danieldfgro2000/mower_bot/docs/engineering/technical/README.md

# Technical engineering index

This category owns the detailed engineering baseline, requirements, supplier
evidence, interfaces and unqualified studies. A listed part or calculated
clearance is not a release or safety qualification.

| Technical scope | Authoritative source |
| --- | --- |
| Estimate, alternatives, sourcing evidence and decisions | [Chassis BOM](bom/chassis-bom.md) · [Sources](bom/sources.md) · [Feedback](bom/feedback.md) |
| Component requirements, fit and supplier evidence | [Numbered module directory](modules/README.md) |
| Detailed estimates and allowances | [Cost breakdown](cost-breakdown.md) · [Cost ledger](bom/chassis-bom.csv) |
| Procurement and build release holds | [Chassis build requirements](chassis-build-requirements.md) |
| Width, packaging, slope and stability screen | [Width and slope feasibility](width-and-slope-sizing.md) |
| CAD geometry, modeled assumptions and clashes | [CAD study guide](cad/README.md) · [Editable SCAD model](cad/module-01-track-pod-fit.scad) |

Use the [generated presentation](../presentation/README.md) for a concise
summary with the 3D viewer. See the [agent guide](../agents/README.md) for
maintenance procedures.

[↑ Back to engineering documentation](../README.md)
