danieldfgro2000/mower_bot/docs/engineering/modules/02-drive-train/README.md

# Module 02 — Drive train

**Summary:** Start with the motor, inspect its price and data, then follow
the mounting path to the track. HPM5000B, EZ-A48500 and FDB 13 C are the
costed candidates; custom reduction and brake installation remain unpriced.
Neither these nor non-additive alternatives are approved or installed selections.

| Part / configuration | Price, data and next connection |
| --- | --- |
| [HPM5000B main candidate](propulsion.md#hpm5000b-main-motor-candidate) | [Price](propulsion.md#hpm5000b-purchase-scope-and-price) · [Specifications](propulsion.md#hpm5000b-ratings-and-sourcing-limits) · [Mounting to the track](propulsion.md#motor-to-track-mounting) |
| [EZ-A48500 controller](propulsion.md#ez-a48500-controller-candidate) | [Price and comparison](propulsion.md#ez-a48500-controller-candidate) · [Electrical compatibility](propulsion.md#compatibility-and-duty-limitations) |
| [Former BLDC 48 V planetary package](propulsion.md#48-v--approximately-2-kw-per-drive) | [Non-additive motor/controller/brake reference](propulsion.md#48-v--approximately-2-kw-per-drive) · [Output shaft and bearings](propulsion.md#ps16-output-shafts-and-bearings) |
| [Reduction, drive hub and supports](propulsion.md#motor-to-track-mounting) | [In-drum study](propulsion.md#hpm5000b-planetary-in-drum-study) · [Track engagement](../01-structure-and-running-gear/running-gear.md#drive-drum-study) · [Frame mounting plates](../01-structure-and-running-gear/frame.md#motor-and-reducer-mounting-plates) |
| [Precima FDB 13 C holding brake](propulsion.md#precima-fdb-13-c-holding-brake-candidate) | [Supplier price and data](propulsion.md#precima-fdb-13-c-holding-brake-candidate) · [HPM fitment](propulsion.md#fdb-13-c-to-hpm5000b-fitment) · [Independent stop](../06-safety-controls-and-sensors/safety-controls.md#ps28-independent-stopping-and-normal-control) |

**Related documents:** [All drive parts](propulsion.md#parts-at-a-glance) ·
[Module cost detail](../../cost-breakdown.md#02--drive-train) ·
[All modules](../README.md)

[↑ Back to module overview](README.md#module-02--drive-train)
