danieldfgro2000/mower_bot/docs/engineering/modules/05-power-cables-and-electronics/README.md

# Module 05 — Power cables and electronics

**Summary:** Power and signal wiring, protective switching, supplies, and
electronics enclosures. Component ratings and installation remain unqualified;
independent stop requirements belong to [Module 06](../06-safety-controls-and-sensors/README.md).

| Start with a part | Then inspect its connection |
| --- | --- |
| [Power cable, lugs and connectors](cables-connectors.md#ps23-high-current-harness) | [Fuse coordination](power-distribution.md#ps21-main-fuses-disconnects-and-contactors) · [Crimp tools/dies](../07-workshop-and-support/workshop.md#ps36-instruments-and-workshop-tools) |
| [Contactors and disconnects](power-distribution.md#ps21-main-fuses-disconnects-and-contactors) | [Battery/BMS](../04-battery-and-charging/batteries.md#ps18-battery-packs-and-bms) · [Independent stop](../06-safety-controls-and-sensors/safety-controls.md#ps28-independent-stopping-and-normal-control) |
| [Control supplies](power-distribution.md#ps24-control-supplies-and-branch-protection) | [Control boards](../06-safety-controls-and-sensors/safety-controls.md#ps29-normal-control-and-diagnostics) · [Brake-coil loads](../02-drive-train/propulsion.md#ps15-mechanical-brakes) |
| [Printed boxes and glands](power-distribution.md#ps25-printed-enclosures-and-cable-glands) | [Controller heat path and mounting](power-distribution.md#ps27-thermal-paths-and-enclosure-hardware) · [Cable entry](cables-connectors.md#ps23-high-current-harness) |
| [Signal cable/connectors](cables-connectors.md#ps26-signal-harness-and-communications) | [Sensors/logger](../06-safety-controls-and-sensors/safety-controls.md#ps31-installed-instrumentation-and-logging) · [Moving width harness](../03-width-adjustment/width-adjustment.md#ps13-width-harness-and-screw-guard) |

**Related documents:** [Cable/connector parts and costs](cables-connectors.md#parts-at-a-glance) ·
[Power-distribution parts and costs](power-distribution.md#parts-at-a-glance) ·
[Module cost detail](../../cost-breakdown.md#05--power-cables-and-electronics) ·
[All modules](../README.md)

[↑ Back to module overview](README.md#module-05--power-cables-and-electronics)
