danieldfgro2000/mower_bot/docs/engineering/modules/01-structure-and-running-gear/README.md

# Module 01 — Structure and running gear

**Summary:** The two tracked pods and their connecting frame. Dimensions,
loads, materials, and undercarriage compatibility remain unqualified; neither
scope releases procurement or fabrication.

| Start with a part | Then inspect its connection |
| --- | --- |
| [Track, rollers and tensioner: choices, costs and data](running-gear.md#parts-at-a-glance) | [Drive drum](running-gear.md#drive-drum-study) → [motor-to-track mounting](../02-drive-train/propulsion.md#motor-to-track-mounting) |
| [Motor mounting plates](frame.md#motor-and-reducer-mounting-plates) | [Motor data](../02-drive-train/propulsion.md#parts-at-a-glance) · [Output bearings](../02-drive-train/propulsion.md#ps16-output-shafts-and-bearings) |
| [Frame, pivots, locks and guards](frame.md#parts-at-a-glance) | [Width screw and supports](../03-width-adjustment/width-adjustment.md#ps10-screw-drive-and-supports) · [Width holding](../03-width-adjustment/width-adjustment.md#width-holding-and-stopping) |
| [Installed lifting/recovery points](frame.md#ps32-installed-lifting-and-recovery-points) | [Transport straps and service supports](../07-workshop-and-support/workshop.md#ps33-transport-straps-and-service-supports) |
| [Pod-fit CAD](../../cad/module-01-track-pod-fit.scad) | [Battery fit and removal](../04-battery-and-charging/batteries.md#battery-to-pod-fit) · [Tensioner clearance](../../width-and-slope-sizing.md#tensioner-and-idler-interfaces) |

**Related documents:** [Running-gear scope](running-gear.md) ·
[Frame, scissor and spine scope](frame.md) ·
[Module cost detail](../../cost-breakdown.md#01--structure-and-running-gear) ·
[All modules](../README.md)

[↑ Back to module overview](README.md#module-01--structure-and-running-gear)
