danieldfgro2000/mower_bot/docs/engineering/modules/03-width-adjustment/README.md

# Module 03 — Width adjustment

**Summary:** The proposed powered width-adjustment mechanism, from the reused
motor to the screw, feedback, and guarding. Holding and motion limits remain
unresolved; this is not a released mechanism.

| Start with a part | Then inspect its connection |
| --- | --- |
| [Reused motor: data and cost basis](width-adjustment.md#donor-motor-and-allowance) | [Coupling, screw and supports](width-adjustment.md#ps10-screw-drive-and-supports) → [scissor pivots](../01-structure-and-running-gear/frame.md#ps05-scissor-pivots) |
| [Converter and reversible driver](width-adjustment.md#ps11-width-drive-power-and-protection) | [Motor current/duty requirements](width-adjustment.md#ps09-reused-wiper-motor) · [Traction-pack limits](../04-battery-and-charging/batteries.md#ps18-battery-packs-and-bms) |
| [Encoder, reference and limits](width-adjustment.md#ps12-width-feedback-and-limits) | [Turns-to-width relationship](width-adjustment.md#position-feedback-and-rolling-speed) · [Positive lock and hard stops](../01-structure-and-running-gear/frame.md#ps06-width-holding-and-hard-stops) |
| [Harness and screw guard](width-adjustment.md#ps13-width-harness-and-screw-guard) | [Signal routing](../05-power-cables-and-electronics/cables-connectors.md#ps26-signal-harness-and-communications) · [Main scissor guards](../01-structure-and-running-gear/frame.md#ps07-guards-and-edge-protection) |

**Related documents:** [All width-drive parts and costs](width-adjustment.md#parts-at-a-glance) ·
[Holding and stopping conflict](width-adjustment.md#width-holding-and-stopping) ·
[Module cost detail](../../cost-breakdown.md#03--width-adjustment) ·
[All modules](../README.md)

[↑ Back to module overview](README.md#module-03--width-adjustment)
