danieldfgro2000/mower_bot/docs/engineering/modules/06-safety-controls-and-sensors/README.md

# Module 06 — Safety controls and sensors

**Summary:** Independent stopping, normal controls, interlocks, sensors, and
logging. Mobile-app control and a general hardware E-stop are owner intent,
not verified stopping behavior; all requirements remain on hold.

| Start with a part | Then inspect its connection |
| --- | --- |
| [E-stop, relay and reset](safety-controls.md#ps28-independent-stopping-and-normal-control) | [Contactors](../05-power-cables-and-electronics/power-distribution.md#ps21-main-fuses-disconnects-and-contactors) · [Motor braking and mechanical hold](../02-drive-train/propulsion.md#owner-braking-direction-2026-10-27) |
| [Control boards and diagnostics](safety-controls.md#ps29-normal-control-and-diagnostics) | [Power supplies](../05-power-cables-and-electronics/power-distribution.md#ps24-control-supplies-and-branch-protection) · [Signal harness](../05-power-cables-and-electronics/cables-connectors.md#ps26-signal-harness-and-communications) |
| [Tilt and guard interlocks](safety-controls.md#ps30-tilt-sensing-and-interlocks) | [Guard mounting](../01-structure-and-running-gear/frame.md#ps07-guards-and-edge-protection) · [Configuration-dependent stability](../../width-and-slope-sizing.md#lateral-static-tipping-screen) |
| [Drive sensors and logger](safety-controls.md#ps31-installed-instrumentation-and-logging) | [Clamp meter and measurement tools](../07-workshop-and-support/workshop.md#ps36-instruments-and-workshop-tools) · [Planned bench observations](../07-workshop-and-support/workshop.md#test-method-and-evidence) |

**Related documents:** [All controls/sensors and costs](safety-controls.md#parts-at-a-glance) ·
[Module cost detail](../../cost-breakdown.md#06--safety-controls-and-sensors) ·
[All modules](../README.md)

**Retired cost number:** 06.02 was the industrial operator remote purchase
allowance. It is intentionally left unused after the
[mobile-app control decision](../../bom/feedback.md#f10-workshop-equipment-test-method-and-mobile-app-control);
remaining submodule numbers are retained for stable cross-references.
The app is not the independent emergency stop.

[↑ Back to module overview](README.md#module-06--safety-controls-and-sensors)
