danieldfgro2000/mower_bot/docs/engineering/modules/07-workshop-and-support/README.md

# Module 07 — Workshop and support

**Summary:** Bench fixture, workshop tools, handling equipment, consumables,
and PPE for planned staged checks. Torque remains calculated, not measured;
reused inventory and all test arrangements still need qualification.

| Start with an item | Then inspect what it serves |
| --- | --- |
| [Workshop tools: prices, reuse and limits](workshop.md#ps36-instruments-and-workshop-tools) | [Power connectors/crimping](../05-power-cables-and-electronics/cables-connectors.md#ps23-high-current-harness) · [Frame joints/torque wrench](../01-structure-and-running-gear/frame.md#ps08-fasteners-coatings-and-labels) |
| [Guarded bench fixture](workshop.md#ps34-bench-fixture-and-controls) | [Motor/drive interfaces](../02-drive-train/propulsion.md#motor-to-track-mounting) · [Independent stop](../06-safety-controls-and-sensors/safety-controls.md#ps28-independent-stopping-and-normal-control) |
| [Transport straps and supports](workshop.md#ps33-transport-straps-and-service-supports) | [Installed frame points](../01-structure-and-running-gear/frame.md#ps32-installed-lifting-and-recovery-points) |
| [Consumables and initial spares](workshop.md#ps37-fabrication-consumables) | [Frame weldments](../01-structure-and-running-gear/frame.md#ps04-frame-stock-and-weldments) · [Spare-part matching](workshop.md#ps38-initial-spare-parts) |
| [PPE, fire provision and cleaning](workshop.md#ps39-ppe-charging-area-and-cleaning) | [Charging conditions](../04-battery-and-charging/batteries.md#ps20-charging-and-charge-interlocks) · [Controlled bench area](workshop.md#ps34-bench-fixture-and-controls) |

**Related documents:** [All workshop items and costs](workshop.md#parts-at-a-glance) ·
[Test method and its limits](workshop.md#test-method-and-evidence) ·
[Module cost detail](../../cost-breakdown.md#07--workshop-and-support) ·
[All modules](../README.md)

**Retired cost number:** 07.03 was the dynamometer/torque-measurement package.
It is intentionally left unused after the
[test-method decision](../../bom/feedback.md#f10-workshop-equipment-test-method-and-mobile-app-control);
later submodule numbers are retained for stable cross-references.

[↑ Back to module overview](README.md#module-07--workshop-and-support)
