danieldfgro2000/mower_bot/docs/engineering/technical/modules/01-structure-and-running-gear/running-gear.md

# Tracks and running gear

**Status:** DRAFT / HOLD; engineering estimate and unqualified requirements.
No procurement, fabrication, energizing or operation is authorized.

**Summary:** Follow the track around the drive drum, support rollers, idler,
and tensioner. Nominal track size and layout choices are study inputs;
matched profiles, bearings, clearances, and load ratings remain unqualified.

## Parts at a glance

| Part to inspect | Current choice / status | Cost and specifications | Fit / next component |
| --- | --- | --- | --- |
| [Rubber track](running-gear.md#ps01-rubber-tracks) | PowerTrack `180×72×37` initial sourcing preference; `200×72×40` owner-accepted candidate for the longer-loop study; `200×72×36` remains the unchanged baseline study reference | [Found prices](running-gear.md#prices-found-tracks-rollers-and-idlers) · [Baseline allowance](running-gear.md#0101-rubber-tracks) · [Track requirements](running-gear.md#ps01-rubber-tracks) | [Drive drum engagement](running-gear.md#drive-drum-study) |
| [Drive drum / sprocket](running-gear.md#drive-drum-study) | 350 mm physical OD is a flexible study placeholder; tooth/profile match open | [Baseline sprocket/hub allowance](running-gear.md#0102-sprockets-idlers-rollers-and-tensioners) · [Drum study](running-gear.md#drive-drum-study) | [Motor-to-track mounting](../02-drive-train/propulsion.md#motor-to-track-mounting) |
| [Lower support rollers](running-gear.md#lower-support-rollers) | Bearing-wheel route; printed 120 mm PC/TPU wheels owner-selected, Interwheel 160 mm fallback; four assemblies per track in the study; fit and capacity unqualified | [Found prices](running-gear.md#prices-found-tracks-rollers-and-idlers) · [Roller allowance](running-gear.md#0102-sprockets-idlers-rollers-and-tensioners) · [Roller definition](running-gear.md#lower-support-rollers) | [Axles and bearings](running-gear.md#ps03-axles-bearings-and-track-guides) |
| [Fixed upper rollers and spring idler](running-gear.md#spring-tensioner-concept) | Owner-selected sliding front-idler spring + fixed upper roller; custom supports modeled, loads unqualified | [Roller/tensioner allowances](running-gear.md#0102-sprockets-idlers-rollers-and-tensioners) · [Travel/load requirements](running-gear.md#ps02-sprockets-rollers-and-tensioners) | [Battery and carrier clearance](running-gear.md#tensioner-and-idler-interfaces) |
| Front idler | Bearing-wheel route preferred; priced excavator alternative also recorded; neither fit qualified | [Found prices](running-gear.md#prices-found-tracks-rollers-and-idlers) · [Idler allowance](running-gear.md#0102-sprockets-idlers-rollers-and-tensioners) · [Supplier limitations](running-gear.md#s37-bearing-wheel-roller-and-idler-candidates) | [Track compatibility](running-gear.md#ps01-rubber-tracks) |
| [Axles, bearings and guides](running-gear.md#ps03-axles-bearings-and-track-guides) | Sizes, fits and retained assembly open | [Support costs](running-gear.md#0103-track-axles-bearings-guides-and-scrapers) · [Required data](running-gear.md#ps03-axles-bearings-and-track-guides) | [Pod frame](frame.md#ps04-frame-stock-and-weldments) |

**3D study:** Click a thumbnail in the [local CAD reader](../../cad/README.md)
to select the part; clicking its mesh opens the corresponding section here.
The revised candidate study shows the accepted 200 x 72 x 40 track, unchanged
paired 120 mm lower wheels, a raised 120 mm upper pair and 200 mm bought idler
pair. Battery/tray clashes are cleared with provisional margins. Guide
dimensions are schematic. U supports, axles, a fixed upper mast and sliding
spring-idler hardware are now modeled custom proposals; their loads, joints
and durability remain unqualified.

| Track | Drive drum | Idler | Lower rollers |
| --- | --- | --- | --- |
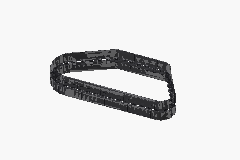
[picture p14: docs/engineering/presentation/viewer/previews/track.png]
3D track
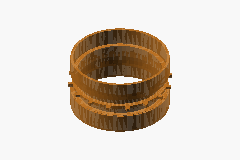
[picture p15: docs/engineering/presentation/viewer/previews/drive-drum.png]
3D drum
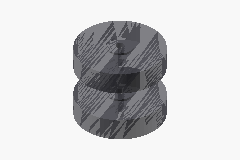
[picture p16: docs/engineering/presentation/viewer/previews/idler.png]
3D idler
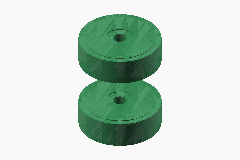
[picture p17: docs/engineering/presentation/viewer/previews/lower-roller-1.png]
3D lower roller
|  |  |  |  |

Other individual rollers: [3D roller 2](../../../presentation/viewer/index.html?component=lower-roller-2) ·
[3D roller 3](../../../presentation/viewer/index.html?component=lower-roller-3) ·
[3D roller 4](../../../presentation/viewer/index.html?component=lower-roller-4).

3D upper return roller

| Lower U supports | Fixed upper support | Sliding idler carriage | Idler spring / reaction |
| --- | --- | --- | --- |
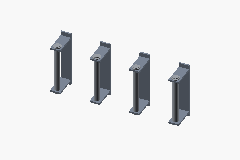
[picture p18: docs/engineering/presentation/viewer/previews/lower-roller-supports.png]
3D lower U supports
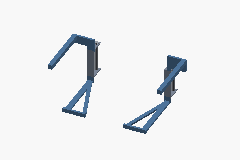
[picture p19: docs/engineering/presentation/viewer/previews/upper-roller-support.png]
3D upper support
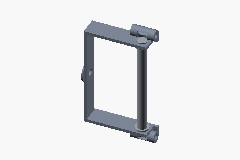
[picture p20: docs/engineering/presentation/viewer/previews/idler-carriage.png]
3D sliding idler carriage
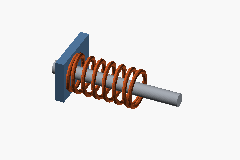
[picture p21: docs/engineering/presentation/viewer/previews/idler-spring.png]
3D idler spring
|  |  |  |  |

**Further detail:** [Prices found](running-gear.md#prices-found-tracks-rollers-and-idlers) ·
[Track length check](running-gear.md#track-length-check) ·
[Release requirements](running-gear.md#specification-and-inspection-requirements) ·
[Roller and drum concepts](running-gear.md#ps02-sprockets-rollers-and-tensioners) ·
[Sourcing](running-gear.md#sourcing) ·
[Interfaces](running-gear.md#interfaces-with-other-scopes) ·
[Itemized costs](running-gear.md#detailed-module-costs) ·
[Procurement and holds](running-gear.md#procurement-and-release-holds) ·
[Decision records](running-gear.md#decision-records) ·
[Supplier evidence](running-gear.md#supplier-evidence)

**Related documents:** [Pod-fit CAD](../../cad/module-01-track-pod-fit.scad) ·
[Chassis BOM](../../bom/chassis-bom.md) ·
[All modules](../README.md#module-directory)

## Prices found: tracks, rollers and idlers

**Public prices recorded 2026-10-29, not BOM allowances.** Product names below
open the supplier listings. These are unqualified sourcing candidates;
dimensions, including drum diameter, remain flexible.

| Part / supplier | Price per purchased piece | Pair / assembly price | Price basis |
| --- | ---: | ---: | --- |
| **Track: PowerTrack 180 x 72 x 37**, sourcing preference ([buy / price](https://www.powertrack.it/en/powertrack-rubber-tracks/2001-rubber-tracks-for-miniexcavators-180x72x37-0793596791918.html)) | **EUR91.35** | **EUR169.92 for two tracks**, after 7% pair discount | Includes 22% Italian VAT; pair is EUR139.28 net |
| **Track candidate: PowerTrack 200 x 72 x 40**, owner-accepted for evaluation ([buy / price](https://www.powertrack.it/en/powertrack-rubber-tracks/2055-Rubber-tracks-for-miniexcavators-200x72x40-0793596792076.html)) | **EUR119.27** | **EUR221.84 for two tracks**, at EUR110.92 each | Includes 22% Italian VAT; listed in stock; Romanian delivery/VAT unconfirmed |
| Track alternative: PowerTrack 200 x 72 x 36 ([buy / price](https://www.powertrack.it/en/powertrack-rubber-tracks/2023-Rubber-tracks-for-miniexcavators-200x72x36-0793596792038.html)) | **EUR138.52** | **EUR257.64 for two tracks**, after 7% pair discount | Includes 22% Italian VAT; pair is EUR211.18 net |
| **Roller wheel: Interwheel 161.535**, 160 mm PU, 20 mm bore ([buy / price](https://www.interwheel.eu/en/stainless-steel-pu-wheel-160-mm-450-kg.html)) | **EUR22.88** | **EUR45.76 per two-wheel roller** | Excludes VAT, shaft, spacers and bracket |
| **Idler wheel: Interwheel 161.540**, 200 mm PU, 20 mm bore ([buy / price](https://www.interwheel.eu/en/stainless-steel-pu-wheel-200-mm-500-kg.html)) | **EUR26.55** | **EUR53.10 per two-wheel idler** | Excludes VAT, shaft, spacers and bracket |
| Light roller price reference: Interwheel 161.420, 125 mm PU, 10 mm bore ([buy / price](https://www.interwheel.eu/en/stainless-steel-pu-wheel-125-mm-200-kg.html)) | **EUR7.73** | **EUR15.46 per two-wheel roller** | Excludes VAT and mounting parts; shared-shaft suitability unresolved |
| Excavator roller alternative: genuine Kubota, Officine Fabbri ([buy / price](https://www.officinefabbri.it/it/k0083-cingoli-rulli/2700-rullo-inferiore-superiore-originale-kubota-classic-line-k008-3-e-u10-3.html)) | **EUR71.29 net** | One complete roller, not a wheel pair | EUR86.98 including 22% Italian VAT |
| Excavator idler alternative: Astrak ID072/293/00, BaggerteileShop24 ([buy / price](https://baggerteileshop24.de/products/kubota-k008-3-leitrad-mit-halter)) | **EUR186.00 net** | One idler with bracket, not a wheel pair | VAT excluded on the recorded retailer basis |

**Bearing-wheel route, required quantities:** 20 x 160 mm wheels for eight
lower and two upper roller assemblies = **EUR457.60 net**; four x 200 mm
wheels for two idlers = **EUR106.20 net**. With the discounted 180 mm track
pair, the component subtotal is **EUR703.08 net**. Listed Interwheel shipping
to Romania is approximately **EUR71.02**, giving **EUR774.10 before VAT,
track delivery and fabrication/mounting parts**. This is not a delivered
complete-undercarriage price.

**Roller sourcing selection (owner-selected, 2026-10-29): 3D-printed
120 mm roller wheels** with a PC core, TPU 95A tread and two bought 6004-2RS
bearings each. Recommendation, not an owner decision: idlers stay bought
until their tension load is known. The current CAD needs 24 wheels (16 x 120 mm
lower, 8 x 70 mm upper), about **EUR190.79 net** (3DJake sale filament, free
delivery) or EUR222.79 at regular prices, excluding print time and an
enclosure. The Interwheel 160 mm wheels above (EUR457.60 for 20) are the
fallback if print time becomes a bottleneck. Printed wheels have no load
rating; confirm the R2 guide-horn height and roller groove before printing the full set. See
[S38](running-gear.md#s38-3d-printed-roller-wheels-owner-proposed).

**Evidence and limitations:** [Track prices and discount](running-gear.md#powertrack-track-comparison) ·
[Bearing-wheel prices, shipping and fit](running-gear.md#s37-bearing-wheel-roller-and-idler-candidates) ·
[All priced excavator alternatives](running-gear.md#s36-priced-kubota-k008-3-undercarriage-candidates).
Romanian checkout VAT and PowerTrack delivery remain unconfirmed.
The [generated costs below](running-gear.md#detailed-module-costs) are the
unchanged baseline allowances, not these found prices.

## Track length check

**Detail:** [Pitch-loop geometry](running-gear.md#pitch-loop-geometry) ·
[Pod-fit CAD assumptions](running-gear.md#pod-fit-cad-assumptions) ·
[Tensioner and idler interfaces](running-gear.md#tensioner-and-idler-interfaces) ·
[Battery clearance](../04-battery-and-charging/batteries.md#provisional-battery-clearance).

### Pitch-loop geometry

If the listing code follows the usual convention, nominal pitch-loop length is
`72 × 36 = 2,592 mm`. The [PowerTrack page](running-gear.md#s01-powertrack-rubber-tracks) does not confirm that interpretation or
publish the track's measured loop length. For an illustrative two-equal-wheel
oval path with radius `r` and wheel-centre separation `a`:

`2,592 = 2a + 2πr`; longitudinal pitch envelope `E = a + 2r`.

At **r = 100 mm**, `a ≈ 981.8 mm` and `E ≈ 1,181.8 mm`, before actual tread
thickness and structural overhangs. This is **not** the selected sprocket size
or layout. It shows why an 800 mm complete pod length must not be inferred
from the proposed 1,600 mm width or a width/length ratio. Actual roller/idler
geometry, track pitch line and wrap determine the envelope.

### Pod-fit CAD assumptions

The [editable candidate study](../../cad/module-01-track-pod-fit.scad) now uses the
owner-accepted 200 x 72 x 40 candidate, interpreting the code as width, pitch and
link count (2,880 mm assumed pitch loop). The drive drum remains a flexible
**350 mm OD placeholder**; the idler now shows two Interwheel 200 mm wheels,
each 50 mm tread / 60 mm hub with 20 mm bore. This is a candidate representation,
not selection or qualification of that idler.

PowerTrack lists roller type **R2** for this track
([S39](running-gear.md#s39-longer-powertrack-belt-candidates)): each metal
link carries two guide horns and the rollers run on the rubber outboard of
both horns, not between them. The CAD therefore uses a **70 mm tread-face
groove**. Four lower assemblies each have two 120 x 40 mm printed wheels with
an 8 mm tread and two 6004 bearing envelopes per wheel; the 150 mm
lower/upper-pair width is kept, so each printed wheel narrows from 50 to 40 mm.
The Interwheel idler's 50 mm treads sit at Z = +/-60 mm (170 mm tread and
180 mm hub envelopes); the hubs sit radially inside the horn tips. Each horn
flank keeps **6 mm** to the wheel, idler-tread and drum-band faces (5 mm
provisional). The catalogue idler treads reach Z = +/-85 mm, 11 mm past the
start of the illustrative shoulder taper, so their effective contact width is
HOLD. Wheel diameters and bearing dimensions are retained.

The illustrative R2 profile is rounded from image-scale estimates and is
**not supplier dimensions**: per 72 mm link, two trapezoidal horns at
Z = +/-19.5 mm, 19 mm high, 19/6 mm wide and 30/20 mm long at base/tip; a
20 x 30 mm metal link land between them, leaving a 42 mm-long open window per
pitch in a 20 mm central channel; a 3.5 mm inner-face shoulder taper outboard
of Z = +/-74 mm; a 15 x 10 mm ground-edge chamfer; and 36 mm-long, 6 mm-high
tread blocks spanning 12-84 mm from the centreline, alternating sides each
half pitch. The belt stays 20 mm thick, although the R2 image scales to about
31.5 mm (HOLD). Confirm horn, groove and rolling-path dimensions before using
any groove, spacer, bearing fit or printed geometry.

With the assumed 20 mm belt and mid-thickness pitch line, two fixed 70 mm upper pairs
at X = 245 and X = -195, both Y = 510 mm, give **850.308 mm horizontal
end-axis spacing**. Drive X stays -440 mm; the idler is at X = +410.308 mm.
The actual four-circle
tangents and arcs close the 40-link loop. The 504 x 268 x 233 mm battery
is at X = 35, Z = 44 mm with bottom Y = 158 mm; the fixed carrier underside is Y = 140 mm,
10 mm above the lower wheels. Nominal body clearances to the 19 mm R2 horn tips are 41.5 / 104.0 mm
normal to the front/rear return runs. Reserving 10 mm for motion and 5 mm for
deflection/tolerances leaves at least **26.5 mm** versus a provisional 20 mm
running requirement. See the [CAD dimensions and limits](../../cad/README.md#modeled-dimensions-and-limits)
for mesh checks, extraction, transverse fit and remaining holds.

This is a candidate study, not a purchase/baseline change. The recorded
200 x 72 x 40 pair costs EUR221.84 including listed Italian VAT, **EUR51.92
more than the 180 x 72 x 37 pair**, and its listed mass adds 24 kg per pair
versus that initial candidate (8 kg versus the 200 x 72 x 36 baseline reference).
The already-planned upper pair completes the existing 20-wheel quantity;
no extra wheels or changed BOM allowances are implied.

### Low-profile packaging investigation

**Owner brief, 2026-10-29:** Investigate approximately 30 mm-OD rollers on
U-shaped supports (more rollers are acceptable), a lower tray/main track frame,
longer tracks and larger idlers before moving the battery to a side bay.
Place the battery toward one transverse side, not centered, to reduce intrusion
into the width-adjustment space. These are investigation directions, not a
replacement component selection. **Historical investigation:** the revised
SCAD below retains 120 mm lower wheels, rather than adopting the small-wheel
screens.

**First screen:** Neither smaller lower rollers alone nor a longer belt alone
raises the current low front return enough. A higher return path is also needed.
Before buying a large custom idler, investigate using the already-planned upper
roller to route the return above the battery.

| Candidate | Public price each | Pair at listed quantity tier | Status / difference from 37-link pair |
| --- | ---: | ---: | --- |
| [180 x 72 x 37](running-gear.md#s34-powertrack-180-x-72-x-37-candidate), current reference | EUR91.35 | EUR169.92 | Listed in stock |
| [180 x 72 x 40](running-gear.md#s39-longer-powertrack-belt-candidates) | **EUR131.96** | **EUR245.44** | Listed in stock; **+EUR75.52**; nominal loop +216 mm, listed pair mass +4 kg |
| [200 x 72 x 40](running-gear.md#s39-longer-powertrack-belt-candidates), owner-accepted candidate | **EUR119.27** | **EUR221.84** | Listed in stock; **+EUR51.92**; nominal loop +216 mm, width +20 mm; EUR23.60 less per pair than 180 x 72 x 40 |
| [180 x 72 x 41K](running-gear.md#s39-longer-powertrack-belt-candidates) | EUR138.30 | EUR257.24 | Preorder; +EUR87.32; K guide/profile compatibility unconfirmed |
| [180 x 72 x 43Y](running-gear.md#s39-longer-powertrack-belt-candidates) | EUR175.09 | EUR325.66 | Listed in stock; +EUR155.74; Y guide/profile compatibility unconfirmed |

These are public guest-page prices, not Romanian delivered prices. Do not
assume K/Y suffixes describe interchangeable internal profiles.

**Owner clarification, 2026-10-29:** The 200 x 72 x 40 is a valid candidate;
180 mm width is not a constraint. Its assumed nominal loop is 2,880 mm.
Acceptance is for evaluation, not a purchase or replacement of the
baseline allowance. The current CAD now evaluates this candidate. Check the wider belt
against the drum, guides, roller tread positions, tray, pod/scissor width and
removal path; internal guide and engagement geometry remain unknown.

**Roller clarification, 2026-10-29:** Different bearings and short-axle
supports are acceptable, but concentrated loading on smaller rollers is the
owner's concern. The 30/80 mm screens below are historical investigations,
not an accepted diameter reduction. Continue from the 120 mm printed-wheel
concept, evaluating contact loading and load sharing before reducing diameter;
extra rollers alone do not prove equal load distribution.

**Upper roller revision, 2026-10-30 (owner request):** add a second fixed upper
return roller above the battery and reduce both upper rollers to the minimum
diameter. The lower 120 mm rollers are unchanged.

**Small roller limit:** No supplier minimum diameter or dimensioned guide-horn
profile was found for this track; the R2 roller-type image is undimensioned. A 30 mm wheel cannot contain the current 42 mm-OD
6004 bearings. Independent short axles in individual U supports could avoid a
shaft crossing the guide channel, but need different bearings, tread/core
sections, fork clearance and load checks. A common shaft still needs
`wheel radius >= horn height + shaft radius + clearance`; the illustrative
19 mm R2 horns, 20 mm shaft and 5 mm gap imply **68 mm minimum OD**, not a
manufacturer recommendation (the earlier 20 mm placeholder lugs gave 70 mm). **80 mm is a practical study starting point**:
with the existing 8 mm tread, its 64 mm core leaves 11 mm radially around a
42 mm bearing seat. Printed capacity and actual horn clearance remain unknown.
At 4 km/h, 30/80/120 mm wheels turn approximately **707/265/177 rpm**.

**Historical numerical layout, superseded by the 120 mm-wheel CAD above:** retain the flexible
350 mm drive study, 200 mm front idler and 120 mm upper roller. Use a
40-link belt, put the upper roller axis at Y = 400 mm above the lower
pitch tangent, and investigate 80 mm lower rollers with U supports.
An analytic three-circle tangent/arc calculation gives **858.8 mm horizontal
end-axis spacing** and battery X = **+17.6 mm**, with 20 mm conservative
rear end-wheel clearance. A 10 mm running gap above the lower wheels and a
10 mm tray put the battery bottom at Y = **110 mm** and top at **343 mm**.
The continuous assumed guide-tip envelope clears the worst upper battery
corner by **20.4 mm normal to the return**. This assumes a 20 mm belt and
20 mm lugs, and excludes tensioner movement, tolerances and service space;
it is not a complete clash check.

The raised upper roller introduces roughly 90 degrees of belt deflection,
so its reaction is about **1.4 times belt tension**, not just return-belt
weight. Its printed wheels, axle, fork and frame mount require load evaluation;
the existing 200 mm bought-wheel route is a separately priced fallback.
The higher return also increases the overall envelope to about 0.49 m.
Investigate six lower assemblies per track rather than four: this adds brackets
and bearings, so less filament alone does not establish a lower total cost.
No larger-idler purchase is recommended without a public price and exact fit.

**Historical transverse example (180 mm track):** align the tray's inboard edge with the track's
inboard edge and put the extra battery width outboard. For example, a provisional
288 mm tray with 10 mm body-edge margins puts the 268 mm battery center 54 mm
outboard of the 180 mm track center. This leaves no tray overhang into the
central adjustment space, but increases pod body width and shifts pod CG.
Both-pod/scissor/transport and removal clearances still need checking against
the [1 m deck constraint](../../width-and-slope-sizing.md#minimum-width-and-packaging).
The revised 200 mm drum retains a 6 mm inboard axial remainder. The current
210 mm motor/flange/reducer/carrier stack projects 16 mm outboard for the new
reaction plate; brake and reducer-bearing integration are still open.

### Tensioner and idler interfaces

**Owner-selected revision, 2026-10-29:** use a **spring-loaded sliding front
idler and a fixed upper roller**. This supersedes the earlier spring-upper /
motorcycle-fork direction. The front idler keeps its 200 mm bought-wheel
envelopes and nominal axis at X = 410.308, Y = 110 mm. Its proposed yoke runs on
two longitudinal guides, with +/-15 mm geometric stop positions; the two upper axes remain fixed at X = 245 and -195, Y = 510 mm.

The nominal belt stays at 2,880 mm. The ideal tangent path changes when the
idler moves; the modeled 30 mm carriage stroke is not proof of usable travel
for that commercial belt. Wear/slack/compliance, initial setup, preload,
force limits and retention must be established. The
[sliding battery cassette](../04-battery-and-charging/batteries.md#sliding-battery-cassette)
clears the represented supports and spring hardware; terminal datums,
restraints, guards and complete-machine removal remain unqualified.
See the [roller and spring-tensioner concept](running-gear.md#ps02-sprockets-rollers-and-tensioners)
for the required mechanical definition.

The [Cohidrex idler-wheel family](running-gear.md#s26-cohidrex-idler-wheel-family) is a review lead only: it
is described for Trabber tracks, with no dimensions or confirmed compatibility
for the [PowerTrack track](running-gear.md#s01-powertrack-rubber-tracks). The concept sketch marks the idler as unresolved and does not imply
that this product fits.

#### Sliding idler carriage

**Custom proposal:** rear-facing U-yoke, 6 mm cheeks at Z = +/-95-101 mm,
leaving 5 mm outside the bought hubs at the R2 wheel spacing. A 6 mm rear
crossbar is 5 mm behind the wheel envelope. The 206 mm-long, 20 mm axle has
schematic retaining collars between the hubs and cheeks, avoiding the guide
rods. Two 48 mm-long, 22 mm-OD
sleeves have 11 mm bores around 10 mm longitudinal rods at Y = 120,
Z = +/-114 mm: **0.5 mm radial clearance**, not a released bearing fit.
The carrier and tray idler reliefs are 190 mm wide, and the frame has
a swept hub relief keeping 5 mm running clearance.
The fixed guide end blocks remain 16 mm beyond the sleeve ends at maximum
stroke; separate stop collars establish the +/-15 mm geometric limits.
Cheek bores, lubrication/sealing, axial retention and stop fixings are not
manufacturing definitions. See the [connected frame](frame.md#connected-pod-frame-proposal).

## Specification and inspection requirements

All specifications are **HOLD**. Checks describe evidence still required, not
completed tests. Cost-ledger ranges are inclusive.

### PS01: Rubber tracks

**Cost-ledger coverage:** RUN-001:RUN-001

**Part links:** [Track-pair cost](running-gear.md#0101-rubber-tracks) ·
[Supplier dimensions and limits](running-gear.md#s01-powertrack-rubber-tracks) ·
[Drive drum engagement](running-gear.md#drive-drum-study) ·
[Track-loop length](running-gear.md#pitch-loop-geometry).

**2026-10-28 owner clarification:** `200×72×36` is not a mandatory size. It
remains the existing price/study reference while the actual track and matched
undercarriage are selected against the [operating cases](../../../../../plan.md#provisional-engineering-targets)
and complete-pod packaging, including the separate
[obstacle-crossing request](../../../../../plan.md#raised-mower-obstacle-crossing).
The current allowance does not quote a new size or qualify that requested mode.

**Required purchasing/manufacturing definition:** Matched track MPN with
confirmed width, pitch and link count; roller type (R2 listed for the CAD
candidate), guide-horn profile, roller-groove and internal width,
sprocket engagement, load/speed/duty limits,
compound, tension specification and replacement availability;
[PowerTrack tracks (S01)](running-gear.md#s01-powertrack-rubber-tracks) and
[TVH undercarriages (S02)](running-gear.md#s02-tvh-undercarriage-parts) remain leads

**Receiving or first-article evidence:** Identity and dimensional match to supplier
drawings; condition and batch; compatibility with the selected complete undercarriage

### PS02: Sprockets, rollers and tensioners

**Cost-ledger coverage:** RUN-002:RUN-006

**Part links:** [Hardware costs](running-gear.md#0102-sprockets-idlers-rollers-and-tensioners) ·
[Motor-to-track mounting](../02-drive-train/propulsion.md#motor-to-track-mounting).

**Concept details:** [Lower support rollers](running-gear.md#lower-support-rollers) ·
[Drive drum](running-gear.md#drive-drum-study) ·
[Spring tensioner](running-gear.md#spring-tensioner-concept) ·
[Inspection evidence](running-gear.md#sprocket-roller-and-tensioner-inspection).

**Required purchasing/manufacturing definition:** Sprocket tooth count/profile, pitch
geometry, bore/key/hub; idler and roller diameters, flanges, axle interfaces and
capacities. Owner-selected concept: spring-load the longitudinally sliding
front idler and keep the upper return support fixed. Define contact profile
and usable stroke, spring
type/rate/preload, travel stops and retention, service method, track-tension
measurement, and allowable track/bearing/frame loads. Verify the moving envelope
against the battery, carrier, guards and battery-removal path.

#### Lower support rollers

Four support assemblies per track, evenly spaced along the lower run, remain
in the study: paired 120 x 40 mm PC/TPU wheels with two 6004 bearings per wheel,
running outboard of the R2 horns.
The frontmost lower axle moves 15 mm rearward to clear the sliding idler yoke;
equal center spacing becomes 140.103 mm, leaving **20.1 mm** between wheel
envelopes. Each pair has a proposed U support: two 6 mm cheeks with 5 mm
tire-side gaps, a 6 mm top bridge at Y = 134-140 mm, 4 mm above the wheel tops,
and a 20 mm axle through the bearing bores. The center axle underside clears
the assumed lower R2 horn tips by 31 mm. Axle retention collars and 20.5 mm
cheek bores are schematic; bearing fits, welds and tolerances are unreleased.
The tray remains 10 mm above the wheels. Diameter has not been reduced to
obtain fit. Actual track contact area, load sharing and printed-wheel capacity
remain unqualified; extra assemblies alone would not prove equal loading.
See the [pod-fit sketch](../../cad/module-01-track-pod-fit.scad).

**Continue:** [Roller allowance](running-gear.md#0102-sprockets-idlers-rollers-and-tensioners) ·
[Axle/bearing mounting](running-gear.md#ps03-axles-bearings-and-track-guides) ·
[Frame definition](frame.md#ps04-frame-stock-and-weldments).

#### Drive drum study

The track-drive drum outside diameter is unselected; 350 mm is a starting
study value, not a fixed requirement. Choose its pitch/tooth geometry to match
the selected track and set its diameter with the required reduction, torque,
speed and pod packaging.
The [HPM5000B planetary-in-drum study](../02-drive-train/propulsion.md#hpm5000b-planetary-in-drum-study)
shows one possible reduction layout only;
[PowerTrack track engagement geometry](running-gear.md#s01-powertrack-rubber-tracks) and the
drum's sprocket profile remain unverified.

**Illustrative R2 engagement update:** the same 350 mm OD / 200 mm-wide drum
now has two running bands at 35-100 mm from the centreline, carrying the
rubber outboard of the horn pair across a 70 mm groove. A hollow root ring
(306 mm OD, within Z = +/-42 mm) runs 3 mm under the wrapped horn tips, and
side webs at 34-42 mm from the centreline join it to both bands, at least
5 mm from the horns. A 10 mm central disc (Z = -5 to +5 mm, 340 mm OD) carries
**16 discrete schematic teeth**, each tapering from 20 mm long at r = 165 mm
to 10 mm at the assumed r = 185 mm pitch line. The teeth stay 5 mm inside each
horn's inner flank and enter the open 42 mm windows between the 30 mm metal
link lands, about 7.6 mm from the nearest land; the disc rim is 5 mm under
the lands. The root bore is 300.4 mm, clearing the 290 mm stationary motor
plate by 5.2 mm radially and the four motor posts by more than 5 mm.
Teeth are phased to the displayed nominal wrapped links; this
is a static no-intersection illustration, **not a matched sprocket design**.
The 16-tooth count, trapezoidal tooth flanks, 306 mm root OD, shell/web
thicknesses and window engagement are custom visualization assumptions.
In particular, 16 pitches of 72 mm do not establish compatibility with the
assumed 370 mm belt mid-line diameter. Actual drive windows, pitch-line
location, flank profile, tension-dependent meshing and output bearings remain HOLD.

**Part links:** [Motor price and specifications](../02-drive-train/propulsion.md#hpm5000b-main-motor-candidate) ·
[Motor-to-drum attachment](../02-drive-train/propulsion.md#motor-to-track-mounting) ·
[Output shaft/bearings](../02-drive-train/propulsion.md#ps16-output-shafts-and-bearings) ·
[Baseline sprocket/hub allowance](running-gear.md#0102-sprockets-idlers-rollers-and-tensioners).
That allowance is not a quote for a completed custom drum and in-drum gearbox.

#### Spring tensioner concept

**Current direction:** the front idler is the spring tensioner; the upper
roller is fixed. The previous motorcycle-fork / spring-upper concept is
historical, not the current modeled arrangement.

**Custom spring proposal:** a compression coil along X at Y = 110, Z = 0 mm,
between the fixed reaction face X = 233 mm and the moving yoke seat. The
schematic spring is **36 mm OD, 4 mm wire, six active turns plus two end rings**,
on a 12 mm guide rod through a 14 mm moving-seat aperture. Installed seat
separation is 57.036 mm nominal, or **42.036-72.036 mm** over the geometric
+/-15 mm idler stroke. The shortest envelope exceeds the rough eight-wire
solid-height screen of 32 mm; this is not a real spring specification.
The 40 mm moving seat leaves 15 mm to the wheel tread faces, and the coil
leaves 6 mm below the frame crossmember. Select a publicly priced spring only
after tension, rate, preload, buckling, fatigue, corrosion, stops/retention
and service-release energy are assessed. No new priced component or BOM
quantity is implied. The [Cohidrex lead](running-gear.md#s26-cohidrex-idler-wheel-family)
remains unqualified for S01.

#### Fixed upper roller support

**Current return-route CAD proposal:**
two fixed pairs of 70 x 40 mm PC/TPU wheels, front at X = 245 mm and rear at X = -195 mm,
both at Y = 510 mm above the battery. Their 20 mm axles clear the R2 horn tips by 6 mm. 70 mm is the modeled minimum: an 8 mm TPU tread leaves a 54 mm
core and only 6 mm of PC radially around the 42 mm-OD 6004 bearing seat.
Wrap angles are about 58.9° (front) and 32.9° (rear), giving nominal reactions
of about **0.98 and 0.57 times belt tension** under equal-tension assumptions.
The small diameter raises contact stress and belt bending at both rollers;
diameter, core wall and track minimum bend radius are a **HOLD** until track
data and a load assessment exist. Each fixed U support has 6 mm cheeks with
5 mm wheel-side gaps, a 20 mm axle and a bridge below the wheels at
Y = 440-446 mm, leaving **29 mm running clearance** and 84 mm to the battery.
A 10 mm inboard mast and diagonal brace connect each support to the tray/frame;
the rear brace is mirrored to land ahead of its mast. Inner faces are at
Z = -116 mm, 6 mm outside the belt edge and 16 mm from the battery body.
**Second (outboard) support:** each U bridge now laps directly onto one
12 mm-thick horizontal crosshead at Y = 440-452 mm, joined to a straight
25 x 25 mm post on an extended **fixed carrier seat**, not the moving tray,
idler arm or motor brace. The front post is X = 325-350, Z = 154-179 mm;
the rear is X = -300 to -275, Z = 128-153 mm. Both run from Y = 140 to
452 mm and each has a full 625 mm² foot on the fixed 10 mm carrier wing.
The front crosshead spans X = 245-350, Z = 74-179 mm; the rear spans
X = -300 to -177, Z = 74-153 mm. Each is a single flat plate with one
square corner relief: outside its U-cheek attachment it starts at Z = 106 mm
to clear the sloping track. Its root overlaps the actual bridge at
Z = 74-86 mm and the actual +Z cheek at Z = 80-86 mm, rather than a
separate pad floating above them. This is a material load-path model, not a
specified weld or proof of resistance to a roller overload.
The posts sit outside the cassette X span and outside the idler carriage's
plan-view sweep; neither relies on the sliding arm. The fit tests keep at least
5 mm from these members to the battery/tray/clamp extraction sweep, the
idler-carriage stroke (also in plan view), the
battery and motor harnesses, the controller and E-stop, and the running gear.
Battery service is therefore unchanged and needs no extra unbolting step.
The two outboard post/crosshead solids total about **4.37 kg per pod**
(before their overlaps with the existing supports, at 7,850 kg/m³).
They stay within the existing Z = 205 mm outboard envelope, but buckling,
carrier-wing bending, joints and the bridge's
load share are unchecked; the track tension is not yet known.
The supports are not spring-loaded. Printed wheels, axles, supports and joints are
not load-rated. The 16 mm inboard projection must be included in the
two-pod/scissor layout.

**Continue:** [Tensioner allowance](running-gear.md#0102-sprockets-idlers-rollers-and-tensioners) ·
[Spring/roller clearance to the battery](running-gear.md#tensioner-and-idler-interfaces) ·
[Frame attachment requirements](frame.md#ps04-frame-stock-and-weldments).

#### Sprocket, roller and tensioner inspection

**Receiving or first-article evidence:** Matched kit contents; drawing-based
dimensional/alignment report; approved tension/retention and rolling checks under a
separately authorized plan

### PS03: Axles, bearings and track guides

**Cost-ledger coverage:** RUN-007:RUN-009

**Part links:** [Axle, bearing and guide costs](running-gear.md#0103-track-axles-bearings-guides-and-scrapers) ·
[Roller layout](running-gear.md#lower-support-rollers) ·
[Separate drive-output bearings](../02-drive-train/propulsion.md#ps16-output-shafts-and-bearings).

**Required purchasing/manufacturing definition:** Axle grades, diameters/fits, bearing
IDs, seals/lubrication, spacers and axial retention; scraper/guide clearances through
track movement; remove kit overlap

**Receiving or first-article evidence:** Material/part identity, fits and retained
assembly; no binding or prohibited track contact against reviewed limits

[↑ Back to document overview](running-gear.md#tracks-and-running-gear)

## Sourcing

Use the [common sourcing weights](../../bom/sources.md#common-sourcing-weights)
for candidate comparisons. Dimensions are flexible; matched interfaces and
adequate load capacity remain prerequisites.

| Evidence needed | Supplier lead |
| --- | --- |
| Track dimensions and matched undercarriage | [PowerTrack 200 × 72 × 36 listing (S01)](running-gear.md#s01-powertrack-rubber-tracks) · [TVH undercarriage catalog (S02)](running-gear.md#s02-tvh-undercarriage-parts) |
| Bearings and fabrication stock | [DOLD bearing housings (S03)](running-gear.md#s03-dold-bearing-housings) · [Dedeman local stock (S06)](../../bom/sources.md#s06-dedeman-fabrication-supplies) |
| Idler geometry; compatibility unresolved | [Cohidrex idler family (S26)](running-gear.md#s26-cohidrex-idler-wheel-family) |

Catalog links and price proxies are not approved suppliers or delivered quotes.
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
