danieldfgro2000/mower_bot/docs/engineering/technical/modules/04-battery-and-charging/batteries.md

# Batteries, enclosures and charging

**Status:** DRAFT / HOLD; engineering estimate and unqualified requirements.
No procurement, fabrication, energizing or operation is authorized.

**Summary:** Two independent 51.2 V / approximately 100 Ah LiFePO4 packs are
the sizing baseline; modestly higher capacity, including 105 Ah, is acceptable.
DC HOUSE's 100 Ah / 18 A charger bundle is the conditional first choice and
budget reference. Greenboatsolutions and Vatrer remain priced alternatives.
None is qualified for the mower; electrical, packaging and delivery holds remain.

## Parts at a glance

| Part to inspect | Current choice / status | Cost and specifications | Fit / next component |
| --- | --- | --- | --- |
| [DC HOUSE 100 Ah bundle](batteries.md#48-v--approximately-2-kw-per-drive) | First-choice budget candidate; qualification HOLD | [Prices](batteries.md#battery-alternatives) · [Baseline costs](batteries.md#0401-battery-packs-with-integrated-bms) | [Battery-to-pod fit](batteries.md#battery-to-pod-fit) |
| [Greenboatsolutions metal pack](batteries.md#lower-cost-alternative-greenboatsolutions-metal-pack) | Retained €1,199 battery-only alternative; conflicting ratings | [Price and limitations](batteries.md#lower-cost-alternative-greenboatsolutions-metal-pack) | [Pack/BMS requirements](batteries.md#ps18-battery-packs-and-bms) |
| [Vatrer 105 Ah mobile packs](batteries.md#vatrer-105-ah-alternatives) | Separate supplier, bundled 20 A charger; excluded from totals | [UTV, standard and mini prices](batteries.md#vatrer-105-ah-alternatives) | [Controller compatibility](../02-drive-train/propulsion.md#compatibility-and-duty-limitations) |
| [BMS](batteries.md#ps18-battery-packs-and-bms) | Included in pack costs; limits and vehicle/regen behavior unqualified | [Pack/BMS requirements](batteries.md#ps18-battery-packs-and-bms) · [Included-cost treatment](batteries.md#0401-battery-packs-with-integrated-bms) | [Main protection](../05-power-cables-and-electronics/power-distribution.md#ps21-main-fuses-disconnects-and-contactors) |
| [Battery enclosure and restraints](batteries.md#ps19-battery-enclosures-and-restraints) | Separate allowance; containment design open | [Enclosure costs](batteries.md#0402-battery-enclosures-restraints-and-insulation) · [Mechanical requirements](batteries.md#ps19-battery-enclosures-and-restraints) | [Pod, track and tensioner clearance](batteries.md#battery-to-pod-fit) |
| [Charger and charge connector](batteries.md#ps20-charging-and-charge-interlocks) | 18 A chargers included in pack budget; interfaces unqualified | [Chargers](batteries.md#0403-matched-battery-chargers) · [Connectors/interlock harness](batteries.md#0404-charge-connectors-fuse-holders-and-interlock-harness) · [Charge requirements](batteries.md#ps20-charging-and-charge-interlocks) | [Motion-inhibit/stop interface](../06-safety-controls-and-sensors/safety-controls.md#ps28-independent-stopping-and-normal-control) |

**3D study:** Click a thumbnail in the [local CAD reader](../../cad/README.md);
clicking the corresponding mesh returns to the fit/clearance section here.
The battery now uses the DC HOUSE listing's **504 x 268 x 233 mm body**, not
the historical Elker envelope. The revised return and tray clear the body
with provisional margins; an open sliding tray, removable base-clamp concepts
and provisional harness routes are modeled, but terminal datums and restraints remain unqualified. Outboard
the cassette sweep is checked, not a released battery-handling procedure.
[Play the battery removal animation](../../../presentation/viewer/index.html?animation=battery-removal):
the viewer withdraws the tray-level pin, slides the open tray and battery
305 mm outboard on one flat telescopic guide and reengages the pin. The
controller, contactor and cables stay fixed; unbolt the battery leads first.
The animation does not depict releasing the clamps or lifting the pack.
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
