danieldfgro2000/mower_bot/docs/engineering/presentation/viewer/previews/battery-box.png

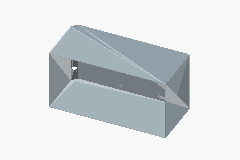
docs/engineering/presentation/viewer/previews/battery-box.png
