danieldfgro2000/mower_bot/docs/engineering/presentation/viewer/previews/battery-hold-down.png

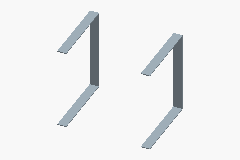
docs/engineering/presentation/viewer/previews/battery-hold-down.png
