danieldfgro2000/mower_bot/docs/engineering/presentation/viewer/previews/controller-harness.png

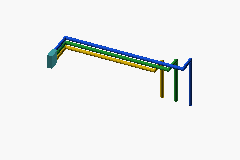
docs/engineering/presentation/viewer/previews/controller-harness.png
