danieldfgro2000/mower_bot/launch_mower_bot_g.png

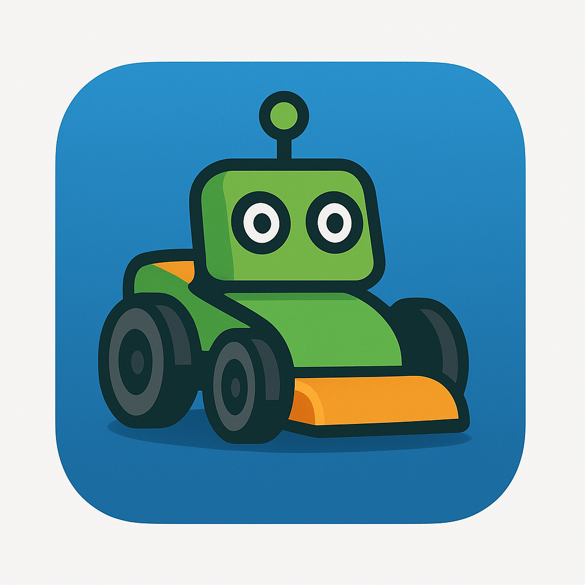
launch_mower_bot_g.png
