danieldfgro2000/mower_bot/docs/engineering/presentation/parts.md

# Presentation parts

**Concise, generated component cards.** For assumptions, requirements,
interfaces and release holds, follow the linked technical detail.

### Open moving battery tray (8 mm steel proposal)

**Status:** Custom 8 mm open steel tray proposal on fixed seats; the battery box is removed. Plate load screen is not qualification of seats, brackets, joints or service stability.

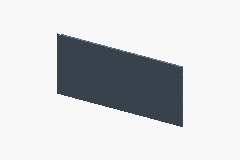
[picture p26: docs/engineering/presentation/viewer/previews/battery-tray.png]
Open moving battery tray (8 mm steel proposal)

| | |
| --- | --- |
| Tray / load screen | 8 mm S235; 85 kg at 1.5 g; 305 mm extraction |

**Read more:** [Open moving battery tray (8 mm steel proposal) technical detail](../technical/modules/04-battery-and-charging/batteries.md#sliding-battery-cassette) · [Technical evidence](../technical/modules/04-battery-and-charging/batteries.md#sliding-battery-cassette)

### Slotted battery-base clamp concepts (four, unqualified)

**Status:** Slotted-jaw and hand-knob concepts only; actual flange grip, captive hardware, locking and restraint loads are unverified.

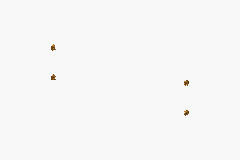
[picture p27: docs/engineering/presentation/viewer/previews/battery-base-clamps.png]
Slotted battery-base clamp concepts (four, unqualified)

| | |
| --- | --- |
| Restraint concept | Four removable slotted jaws and hand knobs, two at each battery short end; no over-pack straps |

**Read more:** [Slotted battery-base clamp concepts (four, unqualified) technical detail](../technical/modules/04-battery-and-charging/batteries.md#sliding-battery-cassette) · [Technical evidence](../technical/modules/04-battery-and-charging/batteries.md#sliding-battery-cassette)

### Fixed flat ball-guide stage and pin bracket

**Status:** Single flat-mounted Accuride guide under the tray; carries the tray only during extraction. Flat rating (about 27.2 kg) is below the 44.9 kg pack, so the guide rating is HOLD. Excluded from baseline costs.

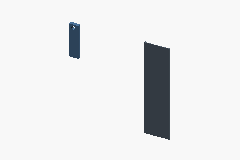
[picture p28: docs/engineering/presentation/viewer/previews/slide-fixed.png]
Fixed flat ball-guide stage and pin bracket

| | |
| --- | --- |
| Guide | 305 mm travel; one 76.2 × 19.1 mm guide, flat under the tray |
| Public price | €119.19 net per pair; one pair covers two pods (one flat guide each) |

**Read more:** [Fixed flat ball-guide stage and pin bracket technical detail](../technical/modules/04-battery-and-charging/batteries.md#sliding-battery-cassette) · [RS Ireland priced pair](https://ie.rs-online.com/web/p/drawer-runners/1886905) · [Accuride datasheet](https://hs-europe.accuride.com/hubfs/Datasheets/9301U-E_en.pdf) · [Technical evidence](../technical/modules/04-battery-and-charging/batteries.md#s40-accuride-battery-extraction-guides)

### Intermediate ball-guide stage (half travel)

**Status:** See technical scope; this is a study element.

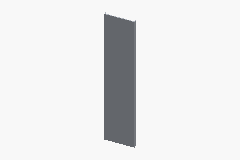
[picture p29: docs/engineering/presentation/viewer/previews/slide-middle.png]
Intermediate ball-guide stage (half travel)


**Read more:** [Intermediate ball-guide stage (half travel) technical detail](../technical/modules/04-battery-and-charging/batteries.md#sliding-battery-cassette)

### Inner ball-guide stage and float pad

**Status:** See technical scope; this is a study element.

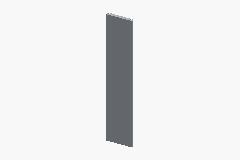
[picture p30: docs/engineering/presentation/viewer/previews/slide-inner.png]
Inner ball-guide stage and float pad


**Read more:** [Inner ball-guide stage and float pad technical detail](../technical/modules/04-battery-and-charging/batteries.md#sliding-battery-cassette)

### Tray locking pin (work / extract)

**Status:** Tray-level two-position positive pin proposal; retention, end stops and engagement indication are not released.

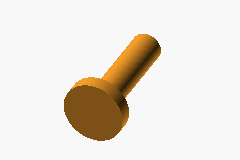
[picture p31: docs/engineering/presentation/viewer/previews/tray-lock-pin.png]
Tray locking pin (work / extract)

| | |
| --- | --- |
| WORK / EXTRACT | 12 mm pin; 12.5 mm bores, 305 mm apart; 35 mm release |

**Read more:** [Tray locking pin (work / extract) technical detail](../technical/modules/04-battery-and-charging/batteries.md#sliding-battery-cassette) · [Technical evidence](../technical/modules/04-battery-and-charging/batteries.md#sliding-battery-cassette)

### Tray-level locking strip (two 12.5 mm bores)

**Status:** See technical scope; this is a study element.

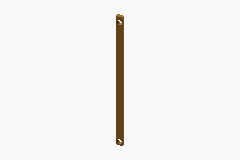
[picture p32: docs/engineering/presentation/viewer/previews/tray-lock-strike.png]
Tray-level locking strip (two 12.5 mm bores)


**Read more:** [Tray-level locking strip (two 12.5 mm bores) technical detail](../technical/modules/04-battery-and-charging/batteries.md#sliding-battery-cassette)

### EZ-A48500 on the fixed electrical plate (published case envelope)

**Status:** Published A-series envelope; terminal offsets, thermal path and exact supplied revision require confirmation.

EZ-A48500 on the fixed electrical plate (published case envelope)
| | |
| --- | --- |
| Drawing envelope | 200 × 164 × 70.47 mm; fixed frame support above the open battery tray |

**Read more:** [EZ-A48500 on the fixed electrical plate (published case envelope) technical detail](../technical/modules/02-drive-train/propulsion.md#ez-a48500-controller-candidate) · [Golden Motor manual, A-series drawing](https://www.goldenmotor.com/controllers/EZkontrol%20Users%20Manual.pdf) · [Technical evidence](../technical/modules/02-drive-train/propulsion.md#ez-a48500-controller-candidate)

### Electrical plate: controller, contactor and E-stop (6 mm, on masts and posts)

**Status:** See technical scope; this is a study element.

Electrical plate: controller, contactor and E-stop (6 mm, on masts and posts)

**Read more:** [Electrical plate: controller, contactor and E-stop (6 mm, on masts and posts) technical detail](../technical/modules/02-drive-train/propulsion.md#ez-a48500-controller-candidate)

### E-stop main contactor (placeholder envelope)

**Status:** E-stop-controlled main contactor envelope only; rating, precharge, coil supply and part selection are HOLD.

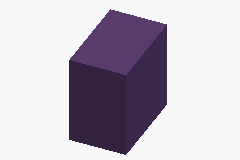
[picture p33: docs/engineering/presentation/viewer/previews/main-contactor.png]
E-stop main contactor (placeholder envelope)

| | |
| --- | --- |
| Function | Between pack and controller B+; one E-stop disconnects both packs |

**Read more:** [E-stop main contactor (placeholder envelope) technical detail](../technical/modules/05-power-cables-and-electronics/power-distribution.md#ps21-main-fuses-disconnects-and-contactors) · [Technical evidence](../technical/modules/04-battery-and-charging/batteries.md#sliding-battery-cassette)

### Emergency stop operator (outboard, beside controller)

**Status:** E-stop operator envelope only; operator part, enclosure rating and coil wiring are HOLD.

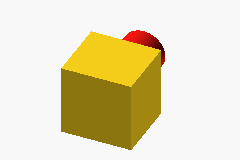
[picture p34: docs/engineering/presentation/viewer/previews/estop-button.png]
Emergency stop operator (outboard, beside controller)

| | |
| --- | --- |
| Placement | Outboard of the track beside the controller; head pressed downward, parallel to the track side |

**Read more:** [Emergency stop operator (outboard, beside controller) technical detail](../technical/modules/05-power-cables-and-electronics/power-distribution.md#ps21-main-fuses-disconnects-and-contactors) · [Technical evidence](../technical/modules/05-power-cables-and-electronics/power-distribution.md#ps21-main-fuses-disconnects-and-contactors)

### Track finger guard tab on the electrical plate

**Status:** Study finger-guard tab bolted to the fixed electrical plate; material and fixings are HOLD.

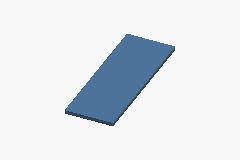
[picture p35: docs/engineering/presentation/viewer/previews/estop-mount.png]
Track finger guard tab on the electrical plate

| | |
| --- | --- |
| Guard | Vertical plate between operator and belt, rising above the track top run |

**Read more:** [Track finger guard tab on the electrical plate technical detail](../technical/modules/05-power-cables-and-electronics/power-distribution.md#ps21-main-fuses-disconnects-and-contactors) · [Technical evidence](../technical/modules/05-power-cables-and-electronics/power-distribution.md#ps21-main-fuses-disconnects-and-contactors)

### Battery leads: red P+ via contactor, black P- direct (fixed, bolted)

**Status:** See technical scope; this is a study element.

Battery leads: red P+ via contactor, black P- direct (fixed, bolted)

**Read more:** [Battery leads: red P+ via contactor, black P- direct (fixed, bolted) technical detail](../technical/modules/05-power-cables-and-electronics/cables-connectors.md#battery-cassette-harness)

### Motor phase leads direct to controller (fixed, clamped route)

**Status:** See technical scope; this is a study element.

Motor phase leads direct to controller (fixed, clamped route)

**Read more:** [Motor phase leads direct to controller (fixed, clamped route) technical detail](../technical/modules/05-power-cables-and-electronics/cables-connectors.md#battery-cassette-harness)

### Phase cable cleats, plate grommet and riser clamps (proposal)

**Status:** See technical scope; this is a study element.

Phase cable cleats, plate grommet and riser clamps (proposal)

**Read more:** [Phase cable cleats, plate grommet and riser clamps (proposal) technical detail](../technical/modules/05-power-cables-and-electronics/cables-connectors.md#battery-cassette-harness)

### Rubber track (200x72x40 R2 candidate fit study)

**Status:** Current CAD candidate; modeled clashes cleared with provisional margins. Profile and load compatibility remain unqualified.

Rubber track (200x72x40 R2 candidate fit study)
| | |
| --- | --- |
| Candidate dimensions | 200 × 72 × 40 (listed size); roller type R2 |
| Roller profile | R2 twin guide horns; CAD profile scaled from an undimensioned image (HOLD) |
| Listed price | €119.27 each; €110.92 each at 2+ (incl. listed Italian VAT) |

**Read more:** [Rubber track (200x72x40 R2 candidate fit study) technical detail](../technical/modules/01-structure-and-running-gear/running-gear.md#pod-fit-cad-assumptions) · [PowerTrack product 2055](https://www.powertrack.it/en/powertrack-rubber-tracks/2055-Rubber-tracks-for-miniexcavators-200x72x40-0793596792076.html) · [Technical evidence](../technical/modules/01-structure-and-running-gear/running-gear.md#s39-longer-powertrack-belt-candidates)

### Drive drum with 16 illustrative link-window teeth (350 mm study)

**Status:** See technical scope; this is a study element.

Drive drum with 16 illustrative link-window teeth (350 mm study)

**Read more:** [Drive drum with 16 illustrative link-window teeth (350 mm study) technical detail](../technical/modules/01-structure-and-running-gear/running-gear.md#drive-drum-study)

### Idler (paired 200x50 wheels; candidate)

**Status:** Priced wheel candidate; track profile and load fit unverified.

Idler (paired 200x50 wheels; candidate)
| | |
| --- | --- |
| Wheel envelope | 200 mm OD × 50 mm tread; paired study |
| Listed price | €26.55 per wheel; €53.10 per pair, ex VAT |

**Read more:** [Idler (paired 200x50 wheels; candidate) technical detail](../technical/modules/01-structure-and-running-gear/running-gear.md#tensioner-and-idler-interfaces) · [Interwheel 161.540](https://www.interwheel.eu/en/stainless-steel-pu-wheel-200-mm-500-kg.html) · [Technical evidence](../technical/modules/01-structure-and-running-gear/running-gear.md#s37-bearing-wheel-roller-and-idler-candidates)

### HPM5000B (body, shaft and mounting pattern)

**Status:** Main cost/study candidate; exact configuration and duty unqualified.

HPM5000B (body, shaft and mounting pattern)
| | |
| --- | --- |
| Supplier family envelope | 206 mm diameter × 126 mm length |
| Planning price | €482.36 each; €964.72 for two bare motors |

**Read more:** [HPM5000B (body, shaft and mounting pattern) technical detail](../technical/modules/02-drive-train/propulsion.md#hpm5000b-main-motor-candidate) · [Golden Motor listing](https://goldenmotorcz.en.made-in-china.com/product/CwmnvfujhxVi/China-HPM5000B-48V-4000RPM-Brushless-DC-Motor-with-CE-Certificate.html) · [Technical evidence](../technical/modules/02-drive-train/propulsion.md#hpm5000b-ratings-and-sourcing-limits) · [Technical evidence](../technical/modules/02-drive-train/propulsion.md#hpm5000b-purchase-scope-and-price)

### Planetary stage 1 (24/72/24 schematic teeth)

**Status:** See technical scope; this is a study element.

Planetary stage 1 (24/72/24 schematic teeth)

**Read more:** [Planetary stage 1 (24/72/24 schematic teeth) technical detail](../technical/modules/02-drive-train/propulsion.md#hpm5000b-planetary-in-drum-study)

### Planetary stage 2 (24/72/24 schematic teeth)

**Status:** See technical scope; this is a study element.

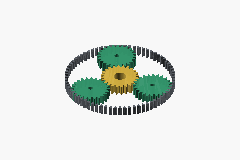
[picture p36: docs/engineering/presentation/viewer/previews/planetary-2.png]
Planetary stage 2 (24/72/24 schematic teeth)


**Read more:** [Planetary stage 2 (24/72/24 schematic teeth) technical detail](../technical/modules/02-drive-train/propulsion.md#hpm5000b-planetary-in-drum-study)

### Planetary stage 3 (16/50/17 schematic teeth)

**Status:** See technical scope; this is a study element.

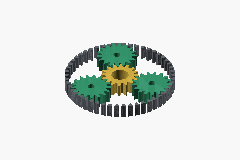
[picture p37: docs/engineering/presentation/viewer/previews/planetary-3.png]
Planetary stage 3 (16/50/17 schematic teeth)


**Read more:** [Planetary stage 3 (16/50/17 schematic teeth) technical detail](../technical/modules/02-drive-train/propulsion.md#hpm5000b-planetary-in-drum-study)

### Final carrier to drum (schematic)

**Status:** See technical scope; this is a study element.

Final carrier to drum (schematic)

**Read more:** [Final carrier to drum (schematic) technical detail](../technical/modules/02-drive-train/propulsion.md#motor-to-track-mounting)

### Lower roller 1 (paired 120x40 PC/TPU study)

**Status:** Owner-selected printed concept; loading and durability unqualified.

Lower roller 1 (paired 120x40 PC/TPU study)
| | |
| --- | --- |
| Wheel concept | 120 mm OD × 40 mm; PC core, TPU 95A tread |
| Material estimate | €190.79 net for 24 wheels (16 × 120 mm, 8 × 70 mm) at recorded sale prices |

**Read more:** [Lower roller 1 (paired 120x40 PC/TPU study) technical detail](../technical/modules/01-structure-and-running-gear/running-gear.md#lower-support-rollers) · [Elegoo PC filament](https://www.3djake.com/elegoo/pc-black-4) · [Elegoo TPU 95A filament](https://www.3djake.com/elegoo/tpu-95a-blue-2) · [6004-2RS bearings](https://www.kugellager-express.de/rillenkugellager-6004-2rs-20x42x12-mm) · [Technical evidence](../technical/modules/01-structure-and-running-gear/running-gear.md#s38-3d-printed-roller-wheels-owner-proposed)

### Lower roller 2 (paired 120x40 PC/TPU study)

**Status:** See technical scope; this is a study element.

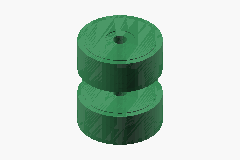
[picture p38: docs/engineering/presentation/viewer/previews/lower-roller-2.png]
Lower roller 2 (paired 120x40 PC/TPU study)


**Read more:** [Lower roller 2 (paired 120x40 PC/TPU study) technical detail](../technical/modules/01-structure-and-running-gear/running-gear.md#lower-support-rollers)

### Lower roller 3 (paired 120x40 PC/TPU study)

**Status:** See technical scope; this is a study element.

Lower roller 3 (paired 120x40 PC/TPU study)

**Read more:** [Lower roller 3 (paired 120x40 PC/TPU study) technical detail](../technical/modules/01-structure-and-running-gear/running-gear.md#lower-support-rollers)

### Lower roller 4 (paired 120x40 PC/TPU study)

**Status:** See technical scope; this is a study element.

Lower roller 4 (paired 120x40 PC/TPU study)

**Read more:** [Lower roller 4 (paired 120x40 PC/TPU study) technical detail](../technical/modules/01-structure-and-running-gear/running-gear.md#lower-support-rollers)

### Front fixed upper roller (paired 70x40 study)

**Status:** Front fixed return roller at the 70 mm minimum, with U support held by an inboard mast and outboard post; printed capacity, bend radius and structural loads unqualified.

Front fixed upper roller (paired 70x40 study)
| | |
| --- | --- |
| Return wheel concept | Paired 70 × 40 mm PC/TPU wheels; front axis X = 245, Y = 510 mm |

**Read more:** [Front fixed upper roller (paired 70x40 study) technical detail](../technical/modules/01-structure-and-running-gear/running-gear.md#fixed-upper-roller-support) · [Technical evidence](../technical/modules/01-structure-and-running-gear/running-gear.md#fixed-upper-roller-support)

### Rear fixed upper roller (paired 70x40 study)

**Status:** Rear fixed return roller above the battery at the 70 mm minimum; printed capacity, bend radius and structural loads unqualified.

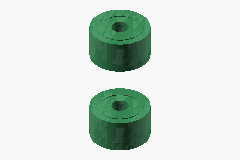
[picture p39: docs/engineering/presentation/viewer/previews/upper-roller-2.png]
Rear fixed upper roller (paired 70x40 study)

| | |
| --- | --- |
| Return wheel concept | Paired 70 × 40 mm PC/TPU wheels; rear axis X = -195, Y = 510 mm |
| Track wrap | About 32.9°, nominal reaction about 0.57 × belt tension |

**Read more:** [Rear fixed upper roller (paired 70x40 study) technical detail](../technical/modules/01-structure-and-running-gear/running-gear.md#fixed-upper-roller-support) · [Technical evidence](../technical/modules/01-structure-and-running-gear/running-gear.md#fixed-upper-roller-support)

### Battery tray (524x288x10 proposed plate)

**Status:** See technical scope; this is a study element.

Battery tray (524x288x10 proposed plate)

**Read more:** [Battery tray (524x288x10 proposed plate) technical detail](../technical/modules/01-structure-and-running-gear/frame.md#ps04-frame-stock-and-weldments)

### Lower roller U supports and axles (proposal)

**Status:** Four proposed U supports; unchanged 120 mm wheels. Axle fits and structural capacity unqualified.

Lower roller U supports and axles (proposal)
| | |
| --- | --- |
| Support geometry | 6 mm cheeks; 20 mm axle; 4 mm bridge/tread gap |

**Read more:** [Lower roller U supports and axles (proposal) technical detail](../technical/modules/01-structure-and-running-gear/running-gear.md#lower-support-rollers) · [Technical evidence](../technical/modules/01-structure-and-running-gear/running-gear.md#lower-support-rollers)

### Four-point motor cradle and connected pod frame (proposal)

**Status:** Reinforced custom frame proposal; local beam screens only. Joints and complete two-pod fit unqualified; no separately established price.

Four-point motor cradle and connected pod frame (proposal)
| | |
| --- | --- |
| Structural connection | Four motor reaction supports → fixed carrier/frame → idler guides |

**Read more:** [Four-point motor cradle and connected pod frame (proposal) technical detail](../technical/modules/01-structure-and-running-gear/frame.md#connected-pod-frame-proposal) · [Technical evidence](../technical/modules/01-structure-and-running-gear/frame.md#connected-pod-frame-proposal)

### Motor reaction plate (290x16 proposal)

**Status:** Custom reaction-plate proposal on the published motor pattern; fasteners and loads unqualified.

Motor reaction plate (290x16 proposal)
| | |
| --- | --- |
| Proposed plate | 290 mm OD × 16 mm; motor moves 16 mm outboard |

**Read more:** [Motor reaction plate (290x16 proposal) technical detail](../technical/modules/01-structure-and-running-gear/frame.md#motor-and-reducer-mounting-plates) · [Technical evidence](../technical/modules/01-structure-and-running-gear/frame.md#motor-and-reducer-mounting-plates)

### Sliding idler yoke and sleeves (proposal)

**Status:** Sliding front-idler proposal with geometric stops; usable belt travel and retained bearing fits unqualified.

Sliding idler yoke and sleeves (proposal)
| | |
| --- | --- |
| Geometric stroke | ±15 mm longitudinal; two 10 mm guides |

**Read more:** [Sliding idler yoke and sleeves (proposal) technical detail](../technical/modules/01-structure-and-running-gear/running-gear.md#sliding-idler-carriage) · [Technical evidence](../technical/modules/01-structure-and-running-gear/running-gear.md#sliding-idler-carriage)

### Idler spring, guide and reaction seat (proposal)

**Status:** Schematic compression spring, not a selected commercial part or qualified tension setting; no established price.

Idler spring, guide and reaction seat (proposal)
| | |
| --- | --- |
| Coil proposal | 36 mm OD, 4 mm wire; 57.036 mm nominal installed envelope |

**Read more:** [Idler spring, guide and reaction seat (proposal) technical detail](../technical/modules/01-structure-and-running-gear/running-gear.md#spring-tensioner-concept) · [Technical evidence](../technical/modules/01-structure-and-running-gear/running-gear.md#spring-tensioner-concept)

### Upper U supports with straight posts on fixed carrier wings (proposal)

**Status:** Fixed U support and axle, held by a braced inboard mast and an outboard crosshead/post on fixed carrier wings; loads and joints unqualified.

Upper U supports with straight posts on fixed carrier wings (proposal)
| | |
| --- | --- |
| Packaging | 29 mm wheel/bridge gap; 16 mm intrusion into central space |
| Second support | 25 × 25 mm posts and 12 mm notched flat crossheads on fixed carrier wings; about 4.37 kg per pod before support overlaps |

**Read more:** [Upper U supports with straight posts on fixed carrier wings (proposal) technical detail](../technical/modules/01-structure-and-running-gear/running-gear.md#fixed-upper-roller-support) · [Technical evidence](../technical/modules/01-structure-and-running-gear/running-gear.md#fixed-upper-roller-support)

### DC HOUSE battery (504x268x233 listing envelope)

**Status:** Listing body clears the revised CAD. Supplied dimensions, terminals, restraints and complete vehicle fit remain on hold.

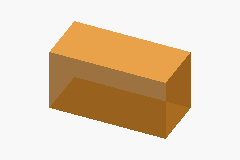
[picture p40: docs/engineering/presentation/viewer/previews/battery.png]
DC HOUSE battery (504x268x233 listing envelope)

| | |
| --- | --- |
| Pack envelope | 504 × 268 × 233 mm per pack |
| Bundle price | €849.99 each incl. listed 18 A charger; tax/delivery unconfirmed |

**Read more:** [DC HOUSE battery (504x268x233 listing envelope) technical detail](../technical/modules/04-battery-and-charging/batteries.md#provisional-battery-clearance) · [DC HOUSE EU/non-DE bundle](https://de.dchousepower.com/products/5-tage-bearbeitungszeit48v-100ah-lifepo4-batterie-mit-metallgehause-bluetooth-und-niedertemperaturschutz-ladegerat-ausserhalb-de) · [Technical evidence](../technical/modules/04-battery-and-charging/batteries.md#s30-dc-house-100-ah-charger-bundle)

### Battery removal arrow (annotation)

**Status:** See technical scope; this is a study element.

Battery removal arrow (annotation)

**Read more:** [Battery removal arrow (annotation) technical detail](../technical/modules/04-battery-and-charging/batteries.md#battery-to-pod-fit)

[↑ Back to presentation](README.md#engineering-pitch)
