danieldfgro2000/mower_bot/docs/engineering/bom/propulsion-alternatives.csv

candidate_id | replaces_item_id | description | voltage_v | cooling | qty_stage_1 | qty_stage_2_total | source_currency | source_unit_price | assumed_vat_percent | fx_usd_per_eur | unit_eur_reference | extended_eur_reference | basis | source_ids | product_url | qualification_or_assumption | technical_reference
ALT-DRV-002 | DRV-001 | BLDC D110BLD2000 48 V motor with planetary provision | 48 | Exact cooling and continuous-duty evidence required | 1 | 2 | USD | 957.86 | 21 | 1.1188 | 1035.94 | 2071.88 | C | S11 | https://www.bldc.com/2000w-planetary-gear-motor | NON-ADDITIVE former baseline; 16:1 planetary provision requires exact quote and output ratings; excludes controller brake freight duty and brokerage; not interchangeable with HPM5000B integration | ../modules/02-drive-train/propulsion.md#48-v--approximately-2-kw-per-drive
