danieldfgro2000/mower_bot/docs/engineering/technical/cad/module-01-track-pod/frame.scad

// Module 01 track-pod fit study part: Fixed carrier, U supports, axles, connected pod frame and upper roller support.
// Included by ../module-01-track-pod-fit.scad; not a standalone model.
// Shares its global parameters (parameters.scad); millimetres.

frame_rail_bottom_y = 90;
frame_rail_thickness = 10;
frame_rail_inner_z = 90;
frame_rear_x = battery_center_x - carrier_length / 2 - 14;
frame_crossmember_width = 20;
frame_crossmember_bottom_y = 130;
frame_crossmember_height = 20;
motor_brace_size = 25;
motor_brace_x_offset = 120;
motor_brace_y_offset = 40;
motor_brace_outer_z = 128;
motor_brace_depth = 25;
front_rail_width = 20;
front_rail_height = 65;
front_rail_inner_z = idler_guide_z + 17;
front_rail_outer_z = front_rail_inner_z + front_rail_width;
front_rail_start_x = idler_center[0] - 200;
front_rail_root_x = idler_center[0] - 145;
front_rail_end_x = idler_center[0] + 67;

function frame_structural_study() = [
    ["post_width_mm", motor_brace_size],
    ["post_height_mm", motor_brace_size],
    ["post_span_mm", motor_brace_outer_z + motor_brace_depth
        - (motor_inboard_face_z - motor_reaction_thickness)],
    ["post_spacing_mm", 2 * motor_brace_y_offset],
    ["post_offset_mm", motor_brace_x_offset],
    ["motor_cg_from_post_root_mm", motor_body_length / 2 + motor_reaction_thickness],
    ["rail_width_mm", frame_rail_thickness],
    ["rail_height_mm", slide_bottom_y - frame_rail_bottom_y],
    ["rail_span_mm", max([for (i = [0 : lower_support_roller_count - 2])
        lower_roller_x(i + 1) - lower_roller_x(i)])],
    ["cross_width_mm", frame_crossmember_width],
    ["cross_height_mm", frame_crossmember_height],
    ["cross_span_mm", 2 * frame_rail_inner_z + frame_rail_thickness],
    ["front_width_mm", front_rail_width],
    ["front_height_mm", front_rail_height],
    ["front_span_mm", front_rail_end_x - front_rail_root_x],
    ["front_guide_offset_mm", front_rail_inner_z + front_rail_width / 2 - idler_guide_z],
    ["plate_net_thickness_mm", motor_reaction_thickness - 8],
    ["motor_pcd_mm", motor_mount_pcd],
    ["motor_bolt_mm", motor_mount_nominal_diameter]
];

module pod_carrier() {
    color([0.3, 0.45, 0.6])
        difference() {
            union() {
                translate([battery_center_x - carrier_length / 2,
                           carrier_underside_y, carrier_center_z - carrier_width / 2])
                    cube([carrier_length, carrier_thickness, carrier_width]);
                // Fixed side wings, not additions to the removable battery tray.
                translate([-300, carrier_underside_y, 128]) cube([105, carrier_thickness, 60]);
                translate([245, carrier_underside_y, 148]) cube([105, carrier_thickness, 40]);
            }
            translate([idler_center[0] - idler_clearance_stroke, idler_path_radius, 0])
                cylinder(d = idler_outer_diameter + 10, h = idler_cutout_height, center = true);
            // Slot for the flat guide; the two remaining plates are the fixed seats.
            translate([slide_slot[0], carrier_underside_y - 1, -200])
                cube([slide_slot[1] - slide_slot[0], carrier_thickness + 2, 400]);
        }
}

module x_cylinder(diameter, length) {
    rotate([0, 90, 0]) cylinder(d = diameter, h = length);
}

module wheel_axle(x, y, collar_z = 88, length = 184) {
    translate([x, y, 0])
        color([0.6, 0.62, 0.65]) {
            cylinder(d = wheel_axis_diameter, h = length, center = true);
            for (side = [-1, 1])
                translate([0, 0, side * collar_z])
                    cylinder(d = 28, h = 3, center = true);
        }
}

module roller_u_support(x, y, upper = false) {
    bridge_y = upper ? 440 : 134;
    bottom_y = upper ? bridge_y : y - 16;
    top_y = upper ? y + 16 : bridge_y + support_plate_thickness;
    cheek_z = printed_wheel_tread_width + guide_gap_placeholder / 2 + support_side_gap;
    color([0.48, 0.52, 0.58])
        difference() {
            union() {
                for (side = [-1, 1])
                    translate([x - 18, bottom_y,
                               side > 0 ? cheek_z : -cheek_z - support_plate_thickness])
                        cube([36, top_y - bottom_y, support_plate_thickness]);
                translate([x - 18, bridge_y, upper ? -86 : -100])
                    cube([36, support_plate_thickness, upper ? 172 : 200]);
            }
            translate([x, y, 0])
                cylinder(d = wheel_axis_diameter + 0.5, h = 210, center = true);
        }
    wheel_axle(x, y);
}

module lower_roller_supports() {
    for (i = [0 : lower_support_roller_count - 1])
        roller_u_support(lower_roller_x(i),
                         lower_belt_inner_face_y + lower_support_roller_diameter / 2);
}

module motor_frame_braces() {
    post_face_z = motor_inboard_face_z - motor_reaction_thickness;
    for (dy = [-motor_brace_y_offset, motor_brace_y_offset]) {
        for (side = [-1, 1])
            translate([drive_center[0] + side * motor_brace_x_offset - motor_brace_size / 2,
                       drive_center[1] + dy - motor_brace_size / 2, post_face_z])
                cube([motor_brace_size, motor_brace_size,
                      motor_brace_outer_z + motor_brace_depth - post_face_z]);
        translate([drive_center[0] - motor_brace_x_offset - motor_brace_size / 2,
                   drive_center[1] + dy - motor_brace_size / 2, motor_brace_outer_z])
            cube([-272 - (drive_center[0] - motor_brace_x_offset - motor_brace_size / 2),
                  motor_brace_size, motor_brace_depth]);
    }
    // Two straight cross-ties close the cradle; the forward tie seats on the carrier wing.
    for (x = [drive_center[0] - motor_brace_x_offset - motor_brace_size / 2, -300])
        translate([x, drive_center[1] - motor_brace_y_offset - motor_brace_size / 2,
                   motor_brace_outer_z])
            cube([motor_brace_size, 2 * motor_brace_y_offset + motor_brace_size,
                  motor_brace_depth]);
}

module front_rail_reinforcement(side) {
    outer_web_z = side > 0 ? front_rail_inner_z : -front_rail_outer_z;
    anchor_z = side > 0 ? frame_rail_inner_z : -front_rail_outer_z;
    anchor_width = front_rail_outer_z - frame_rail_inner_z;
    translate([front_rail_start_x, 150 - front_rail_height, outer_web_z])
        cube([front_rail_end_x - front_rail_start_x, front_rail_height, front_rail_width]);
    translate([front_rail_start_x, 138, anchor_z])
        cube([front_rail_end_x - front_rail_start_x, 12, anchor_width]);
    translate([front_rail_start_x, 90, anchor_z])
        cube([front_rail_root_x - front_rail_start_x, 50, anchor_width]);
}

// Rotating idler hubs end flush with the inner rail plane (|Z| = 90); relieve the
// strip and front anchors by 5 mm radially and axially over the full idler stroke.
idler_hub_relief_diameter = 70;
idler_hub_relief_height = guide_gap_placeholder + wheel_tread_width + idler_hub_width + 10;

module idler_hub_relief() {
    hull()
        for (dx = [-idler_clearance_stroke, idler_clearance_stroke])
            translate([idler_center[0] + dx, idler_path_radius, 0])
                cylinder(d = idler_hub_relief_diameter, h = idler_hub_relief_height, center = true);
}

module pod_frame() {
    difference() {
        pod_frame_body();
        idler_hub_relief();
    }
}

module pod_frame_body() {
    color([0.3, 0.45, 0.6]) {
        motor_frame_braces();
        translate([frame_rear_x, frame_crossmember_bottom_y, -100])
            cube([frame_crossmember_width, frame_crossmember_height,
                  motor_brace_outer_z + motor_brace_depth + 100]);
        for (side = [-1, 1]) {
            rail_z = side > 0 ? frame_rail_inner_z : -frame_rail_inner_z - frame_rail_thickness;
            front_rail_reinforcement(side);
            difference() {
                translate([frame_rear_x, frame_rail_bottom_y, rail_z])
                    cube([idler_center[0] - 140 - frame_rear_x,
                          140 - frame_rail_bottom_y, frame_rail_thickness]);
                // Notch: the fixed guide stage bears on the rails at Y = 129.9.
                translate([slide_slot[0], slide_bottom_y, rail_z - 1])
                    cube([slide_slot[1] - slide_slot[0], 20, frame_rail_thickness + 2]);
            }
            translate([idler_center[0] - 145, 138, rail_z])
                cube([212, 12, 10]);
            for (dx = [-67, 55])
                difference() {
                    translate([idler_center[0] + dx, 112, side * idler_guide_z - 8])
                        cube([12, 38, 16]);
                    translate([idler_center[0] + dx - 0.1, idler_guide_y, side * idler_guide_z])
                        x_cylinder(idler_guide_diameter, 12.2);
                }
            translate([idler_center[0] - 60, idler_guide_y, side * idler_guide_z])
                x_cylinder(idler_guide_diameter, 120);
            for (dx = [-24 - idler_clearance_stroke - 4, 24 + idler_clearance_stroke])
                translate([idler_center[0] + dx, idler_guide_y, side * idler_guide_z])
                    x_cylinder(20, 4);
        }
        translate([spring_fixed_face_x - 8, 134, -100]) cube([8, 6, 200]);
    }
}

module upper_roller_mast(x, y, flip = false) {
    // Inboard mast and diagonal from the tray frame rail; the rear copy is mirrored
    // so its brace lands on the rail ahead of it.
    roller_u_support(x, y, true);
    color([0.3, 0.45, 0.6])
        translate([x, 0, 0]) mirror([flip ? 1 : 0, 0, 0]) {
            translate([-15, 140, -116]) cube([30, 306, 10]);
            hull() {
                translate([-100, 146, -111]) cube([16, 16, 10], center = true);
                translate([0, 438, -111]) cube([16, 16, 10], center = true);
            }
            translate([-110, 134, -116]) cube([130, 12, 22]);
            translate([-18, 440, -116]) cube([36, 6, 36]);
        }
}

module upper_roller_outboard_support(x, y, flip, post_x, post_z) {
    color([0.3, 0.45, 0.6]) {
        arm_from = flip ? post_x : x;
        arm_to = flip ? x + 18 : post_x + 25;
        // A single square relief in this flat plate clears the adjacent sloping belt.
        difference() {
            translate([arm_from, y - 70, 74])
                cube([arm_to - arm_from, 12, post_z + 25 - 74]);
            translate([flip ? arm_from - 1 : x + 18, y - 71, 73])
                cube([flip ? x - 18 - arm_from + 1 : arm_to - x - 17, 14, 33]);
        }
        translate([post_x, carrier_underside_y, post_z])
            cube([25, y - 58 - carrier_underside_y, 25]);
    }
}

module upper_roller_support() {
    upper_roller_mast(upper_roller_center[0], upper_roller_center[1]);
    upper_roller_mast(upper_roller_2_center[0], upper_roller_2_center[1], true);
    upper_roller_outboard_support(upper_roller_center[0], upper_roller_center[1], false, 325, 154);
    upper_roller_outboard_support(upper_roller_2_center[0], upper_roller_2_center[1], true, -300, 128);
}
