danieldfgro2000/mower_bot/arduino/MowerMega/steering.h

#pragma once
#include <AccelStepper.h>

void steeringInit();
void steeringHome();
void steeringUpdate();
void steeringSetAngle(float angle);
float steeringGetCommandedAngle();
bool steeringIsHomed();
void steeringSetHomingNoPulseMs(unsigned long ms);

// Angle helpers
float steeringGetPhysicalAngle();

// Limit queries (after homing)
long steeringGetLimitLeftSteps();
long steeringGetLimitRightSteps();
float steeringGetLimitLeftDeg();
float steeringGetLimitRightDeg();
