danieldfgro2000/mower_bot/(commit log)

2025-08-04 add arduino files to flutter project
2025-08-04 arduino updates
2025-08-04 add arduino path manager
2025-08-15 add delay avoid watchdog reset
    [MowerESP32.ino]
2025-08-26 ESP video stream - switch to separate websocket for video
2025-08-27 ESP video stream - receiving frames after the changes
2025-08-29 fix ws disconnecting after one frame
2025-08-29 switch back to normal ws for video (no async)
2025-09-03 camera ok-ish (low fps, freezing - espresiff implementation
    [partitions.csv]
2025-09-05 stepper motor runs ok
2025-09-12 add check link between mega and esp32
2025-09-12 MEGA-esp32 connection ok - heartbeat
2025-09-13 flutter -> esp32 -> mega ok
2025-09-14 control bloc debounce steer
2025-09-14 mega steering tweaks
2025-09-15 use telemetry for wheel angle on ui
2025-11-09 adjust speed and gear ratio for steering unit
2025-11-19 homing - needed final manual zeroing
2025-11-22 homing - manual zeroing ok-ish
2026-01-26 add path recording - fixing
    [MowerESP32.ino]
2026-03-31 update Homing on MowerMega
2026-10-23 BOM for multi tool
2026-10-27 Braking ideation - use AT Park approach for stationary break and dynamic break from reverse controlled motor
2026-10-28 Refine power train
2026-10-28 Battery research
2026-10-28 Motor and break
2026-10-29 Tracks and rollers and idlers
2026-10-29 Tracks rollers 3D printed
2026-10-29 update track cad
2026-10-29 Update skill for cad to update components based on interference
2026-10-29 track frame
2026-10-29 cad viewer visibility selection
2026-10-29 cad viewer - doc / cad split / focus view
2026-10-29 cad viewer - animation - battery removal
2026-10-29 cad viewer - controller and cables
2026-10-30 CAD - battery box cables, controller position
